Sheep2259/ESP32S3-ov2640-Helium-HAB/tools/hardware-test-output/image_00000/reconstructed.png

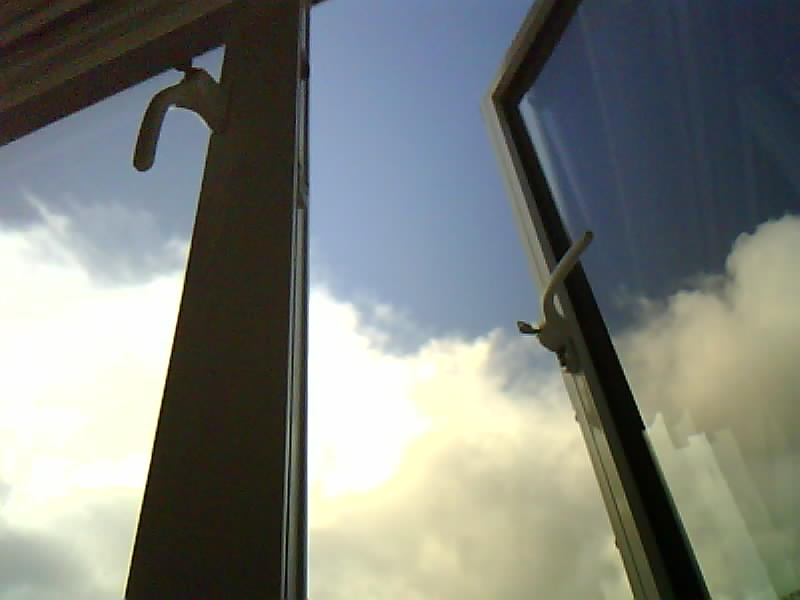
tools/hardware-test-output/image_00000/reconstructed.png
