Sheep2259/ESP32S3-ov2640-Helium-HAB/SCH_Schematic2_2026-08-18.pdf

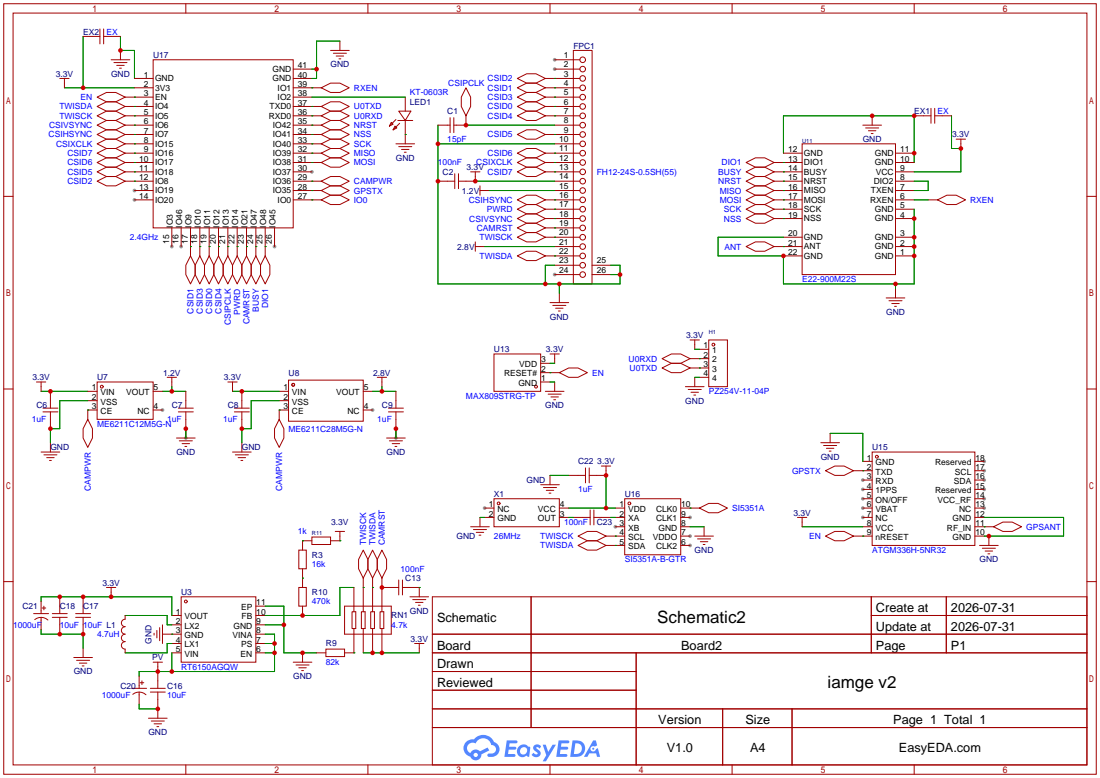
[picture p2: page 1]

Schematic | Schematic2 | Create at | 2026-07-31

Update at | 2026-07-31

Board | Board2 | Page | P1
Drawn | | iamge v2
Reviewed

Version | Size | Page 1 Total 1
V1.0 | A4 | EasyEDA.com
