Sheep2259/ESP32S3-ov2640-Helium-HAB/(list of files, drawings)

Other design files:
ProPrj_iamge v2_2026-08-18.epro
