Sheep2259/ESP32S3-ov2640-Helium-HAB/src/geofence.h

#pragma once

#include <stdint.h>

enum class HeliumRegion : uint8_t { None, Europe, Americas };

extern bool GEOFENCE_no_tx;
extern HeliumRegion GEOFENCE_region;

// Coordinates are latitude/longitude. Transmit is permitted only inside a
// supplied Helium coverage polygon.
void GEOFENCE_position(float latitude, float longitude);
void GEOFENCE_inhibit();
bool pointInPolygonF(uint16_t corners, const float* polygon, float latitude, float longitude);
