Sheep2259/ESP32S3-ov2640-Helium-HAB/(commit log)

2026-08-07 big sloppy redo
    [hab_16MB.csv]
2026-08-19 board info +
    [BOM_Board2_Schematic2_2026-08-18.csv, ProPrj_iamge v2_2026-08-18.epro]
2026-08-28 before first helium test
    [hab_16MB.csv]
